Mistress-Lukutar/tptcm_wifi_bridge/(list of files, drawings)

Other design files:
Altium/TPTCM_WiFi_Bridge/Bridge.PcbDoc
Altium/TPTCM_WiFi_Bridge/Bridge.SchDoc
Altium/TPTCM_WiFi_Bridge/TPTCM_WiFi_Bridge.PrjPcb
