Mistress-Lukutar/tptcm_wifi_bridge/main/main.c

/**
 * @file   main.c
 * @brief  Main application entry point: UART init, WiFi manager, TCP server
 * @author Mistress-Lukutar
 * @date   2026-09-13
 * @version v1.1.0
 */

#include "main.h"

#include <string.h>

#include "esp_log.h"
#include "esp_ota_ops.h"
#include "esp_timer.h"
#include "nvs_flash.h"

/* Component includes */
#include "log_stream.h"
#include "ota_server.h"
#include "printer_uart.h"
#include "raw_tcp_server.h"
#include "wifi_manager.h"

static const char* TAG = "MAIN";

/* ==================== Private Defines ==================== */

#define OTA_CONFIRM_TIMEOUT_US (60ULL * 1000ULL * 1000ULL)

/* ==================== Global Variables ==================== */

App_Context g_app_ctx = {.state = APP_STATE_INIT,
                         .last_error = APP_ERROR_NONE,
                         .ip_str = {0}};

/* ==================== Private Functions =================== */

/**
 * @brief  Confirm the running OTA image when it is still in the
 *         "pending verify" state (rollback safety net)
 */
static void _confirmImageIfPending(void) {
  const esp_partition_t* running = esp_ota_get_running_partition();
  esp_ota_img_states_t state;
  if (esp_ota_get_state_partition(running, &state) == ESP_OK &&
      state == ESP_OTA_IMG_PENDING_VERIFY) {
    if (esp_ota_mark_app_valid_cancel_rollback() == ESP_OK) {
      ESP_LOGI(TAG, "OTA image confirmed in %s", running->label);
    } else {
      ESP_LOGE(TAG, "OTA image confirmation failed in %s", running->label);
    }
  }
}

/**
 * @brief  Fallback confirmation: a bridge that has been alive for a
 *         minute is good enough even if WiFi never came up
 */
static void _otaConfirmTimerCb(void* arg) {
  (void)arg;
  _confirmImageIfPending();
}

/**
 * @brief  WiFi "station got IP" callback: start the print server
 * @param  ip_str Station IPv4 address in dotted-decimal notation
 */
static void _onWifiConnected(const char* ip_str) {
  if (ip_str == NULL) {
    return;
  }
  strncpy(g_app_ctx.ip_str, ip_str, sizeof(g_app_ctx.ip_str) - 1U);
  ESP_LOGI(TAG, "WiFi connected, IP: %s", g_app_ctx.ip_str);

  if (g_app_ctx.state != APP_STATE_READY &&
      g_app_ctx.state != APP_STATE_PRINTING) {
    if (RawTcpServer_Start() != RTS_OK) {
      g_app_ctx.last_error = APP_ERROR_TCP_SERVER;
      ESP_LOGE(TAG, "Failed to start TCP print server");
      return;
    }
    ESP_LOGI(TAG, "Print server ready on %s:%d", g_app_ctx.ip_str,
             CONFIG_TPTCM_TCP_PORT);
  }
  if (LogStream_StartTcp() != LS_OK) {
    ESP_LOGW(TAG, "Log tail server did not start");
  }
  if (OtaServer_Start() != OTA_OK) {
    ESP_LOGW(TAG, "Admin/OTA server did not start");
  }
  _confirmImageIfPending();
  App_SetState(APP_STATE_READY);
}

/**
 * @brief  Initialize NVS, erasing the partition when it is corrupted
 * @return true on success
 */
static bool _initNvs(void) {
  esp_err_t err = nvs_flash_init();
  if (err == ESP_ERR_NVS_NO_FREE_PAGES ||
      err == ESP_ERR_NVS_NEW_VERSION_FOUND) {
    if (nvs_flash_erase() != ESP_OK) {
      return false;
    }
    err = nvs_flash_init();
  }
  return (err == ESP_OK);
}

/* ==================== Public Functions ==================== */

/**
 * @brief  Atomically switch the application state and log the transition
 * @param  new_state Target state
 */
void App_SetState(App_State new_state) {
  if (g_app_ctx.state == new_state) {
    return;
  }
  ESP_LOGI(TAG, "State: %d -> %d", (int)g_app_ctx.state, (int)new_state);
  g_app_ctx.state = new_state;
}

/**
 * @brief  Application entry point
 */
void app_main(void) {
  ESP_LOGI(TAG, "TPTCM WiFi Bridge v1.0.0");

  if (LogStream_Init() != LS_OK) {
    ESP_LOGW(TAG, "Log tee not active, remote logs unavailable");
  }

  if (!_initNvs()) {
    g_app_ctx.last_error = APP_ERROR_NVS;
    ESP_LOGE(TAG, "NVS init failed, credentials will not persist");
  }

  if (PrinterUart_Init() != PUART_OK) {
    g_app_ctx.last_error = APP_ERROR_UART;
    ESP_LOGE(TAG, "Printer UART init failed");
    return;
  }

  if (WifiManager_Init() != WM_OK ||
      WifiManager_Start(_onWifiConnected) != WM_OK) {
    g_app_ctx.last_error = APP_ERROR_WIFI;
    ESP_LOGE(TAG, "WiFi manager start failed");
    return;
  }

  if (!WifiManager_IsConnected()) {
    App_SetState(APP_STATE_PROV);
    ESP_LOGI(TAG, "Waiting for WiFi (saved network or provisioning AP)");
  }

  const esp_timer_create_args_t confirm_args = {
      .callback = _otaConfirmTimerCb,
      .name = "ota_confirm",
  };
  esp_timer_handle_t confirm_timer = NULL;
  if (esp_timer_create(&confirm_args, &confirm_timer) == ESP_OK) {
    (void)esp_timer_start_once(confirm_timer, OTA_CONFIRM_TIMEOUT_US);
  }
}
