Mistress-Lukutar/tptcm_wifi_bridge/(commit log)

2026-09-06 feat: add firmware and altium hardware sources
    UART pins follow the schematic netlist: ESP_TX = IO15
    (U1-8 -> U2 SN74LVC1T45 -> TP4 RX), ESP_RX = IO17
    (TP5 TX -> U3 -> U1-10). GPIO18 is pulled to 3.3 V on
    the board and is no longer used as RX. Flash size
    corrected to 8 MB for the WROOM-1-N8R8 module.
    [Bridge.PcbDoc, Bridge.SchDoc, TPTCM_WiFi_Bridge.PrjPcb]
2026-09-06 docs: match readme and agents to schematic
    Replace MAX3232/RS232 references with the actual board:
    SN74LVC1T45 translators, 5 V TTL printer pads, AMS1117
    power, USB pads on GPIO19/20, corrected reserved-pin
    notes (GPIO35-37 for octal PSRAM, not 17/18).
2026-09-12 feat: harden wifi bring-up, add traffic log
    Log every TCP chunk and every chunk queued to the printer
    UART with a hex preview, gated by TPTCM_LOG_TRAFFIC.
    Harden the RF bring-up: disable modem sleep, cap TX power
    at 10 dBm in both Kconfig and PHY init data (the AMS1117-fed
    3.3 V rail sags on 20 dBm PA spikes and SoftAP beacons stay
    invisible, esp-idf#13508), apply RF settings from the
    interface-start events, add an AP start watchdog and pin
    the provisioning AP to channel 1.
    Default the UART baud rate to 9600 to match the printer
    DIP switches.
    [printer_uart.c, raw_tcp_server.c]
2026-09-12 feat: ota updates and remote log streaming
    Add a dual-slot OTA partition table (partitions.csv) with
    bootloader rollback and two new components:
    - log_stream: tees esp_log into a RAM ring via
    esp_log_set_vprintf, serves a one-client TCP live tail
    (TPTCM_LOG_TCP_PORT) and ring snapshots
    - ota_server: admin page on TPTCM_ADMIN_PORT with device
    info, firmware upload (POST /ota with magic and image
    validation, refused while printing) and the log viewer
    main.c starts both once the station has an IP and confirms
    the running image for the rollback watchdog (on WiFi
    connect plus a 60 s uptime fallback). Migrating from the
    stock single-factory layout takes one USB flash; NVS keeps
    its offse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
    [partitions.csv]
2026-09-12 chore: add pc-side bridge debug scripts
    - find_bridge.ps1: scan a /24 for the device's print port
    - serial_read.ps1: safe COM console reader (DTR off by
    default so the USB-Serial-JTAG never enters download mode)
    - tail_test.ps1 / console_test.ps1: verify the live log
    tail (TCP 3333) and the USB console tee
